icefairy2/Arduino-CNC/doc_pictures/33380556_2360984187275571_8499630215952072704_n.jpg

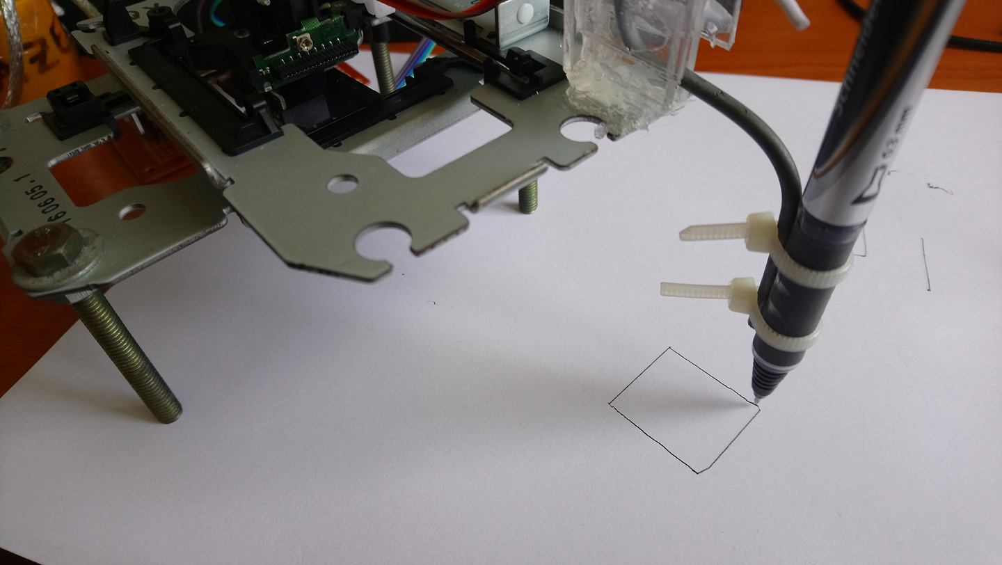
doc_pictures/33380556_2360984187275571_8499630215952072704_n.jpg
