icefairy2/Arduino-CNC/doc_pictures/30739119_2306908542683136_1899229100862603264_n.jpg

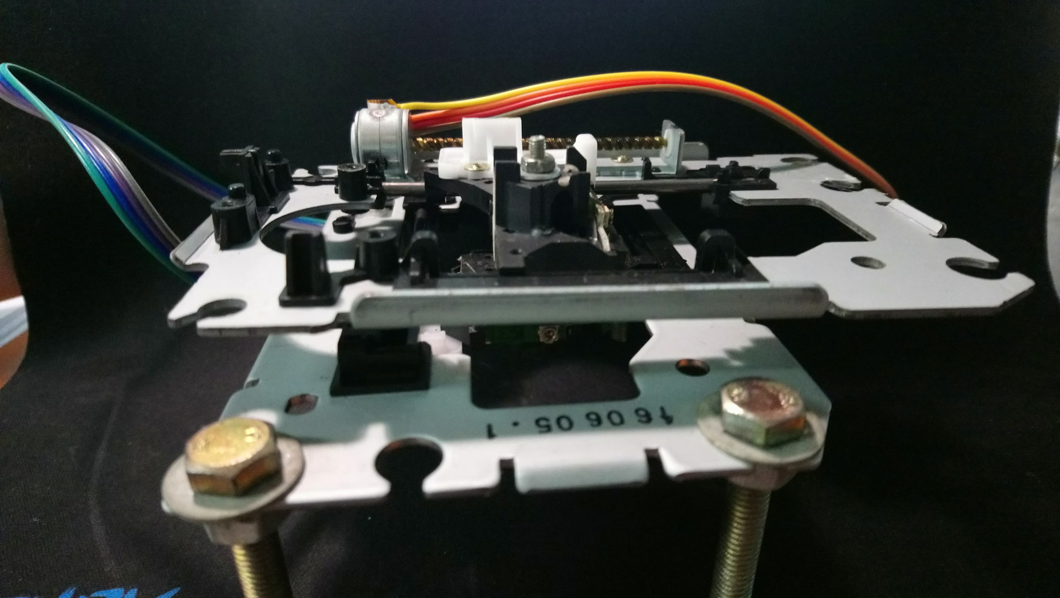
doc_pictures/30739119_2306908542683136_1899229100862603264_n.jpg
