icefairy2/Arduino-CNC/doc_pictures/30706027_2306908366016487_955904147784204288_n.jpg

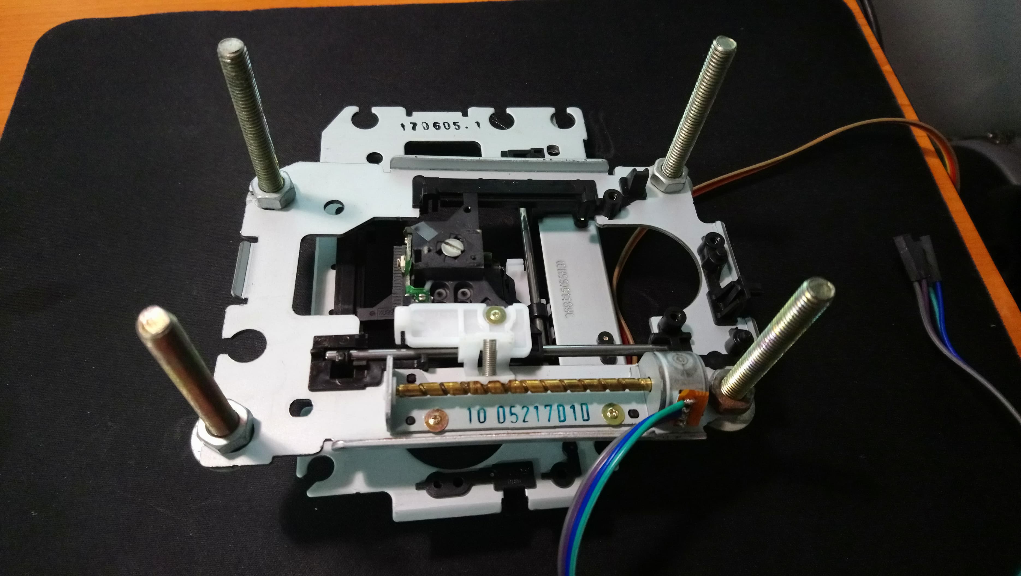
doc_pictures/30706027_2306908366016487_955904147784204288_n.jpg
