icefairy2/Arduino-CNC/doc_pictures/30709478_2306804792693511_1586290099979550720_n.jpg

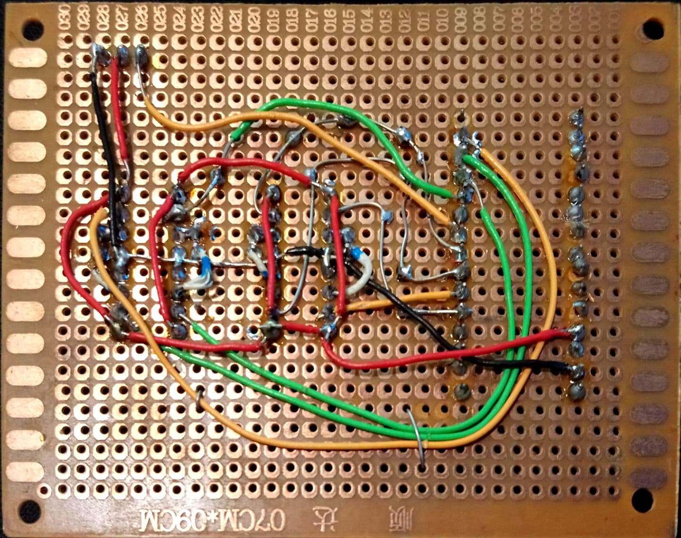
doc_pictures/30709478_2306804792693511_1586290099979550720_n.jpg
