icefairy2/Arduino-CNC/doc_pictures/30711003_2306845702689420_721806899481149440_n.jpg

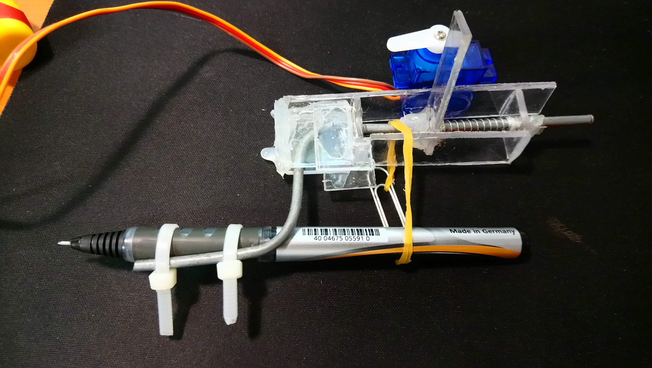
doc_pictures/30711003_2306845702689420_721806899481149440_n.jpg
