icefairy2/Arduino-CNC/doc_pictures/30714753_2306908376016486_1086549236088045568_n.jpg

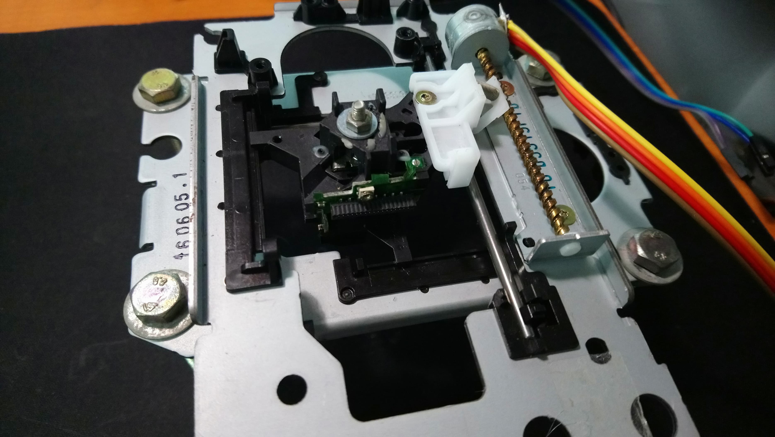
doc_pictures/30714753_2306908376016486_1086549236088045568_n.jpg
