icefairy2/Arduino-CNC/doc_pictures/30716480_2306908196016504_6861736277184610304_n.jpg

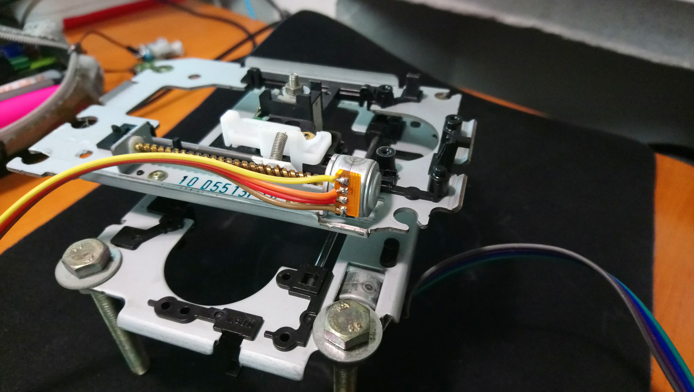
doc_pictures/30716480_2306908196016504_6861736277184610304_n.jpg
