icefairy2/Arduino-CNC/doc_pictures/30727038_2306908006016523_6195921844139196416_n.jpg

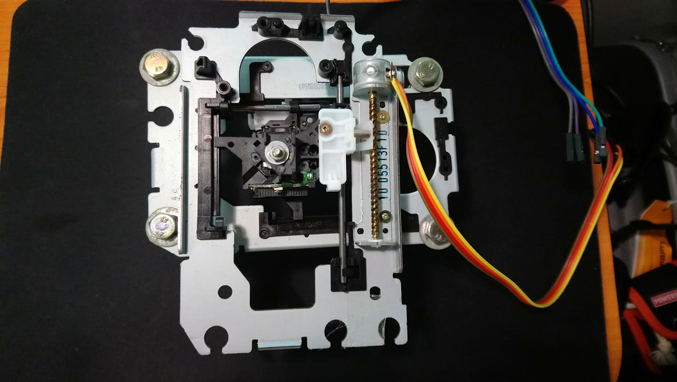
doc_pictures/30727038_2306908006016523_6195921844139196416_n.jpg
