icefairy2/Arduino-CNC/doc_pictures/30738338_2306907972683193_2224676223332646912_n.jpg

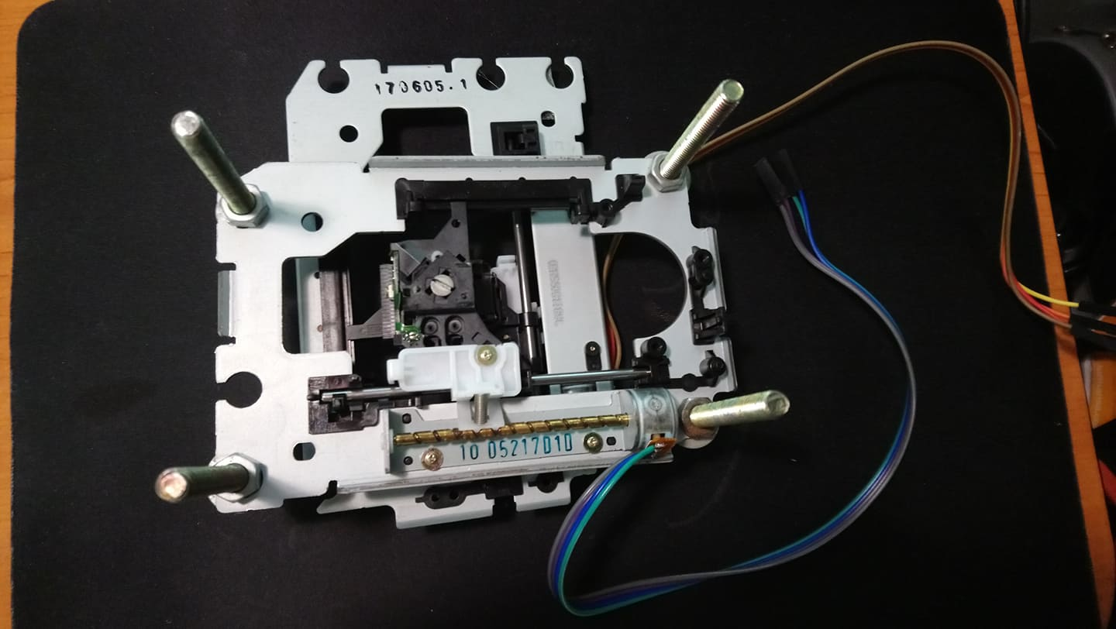
doc_pictures/30738338_2306907972683193_2224676223332646912_n.jpg
