icefairy2/Arduino-CNC/doc_pictures/33426469_2360984143942242_2757224916469153792_n.jpg

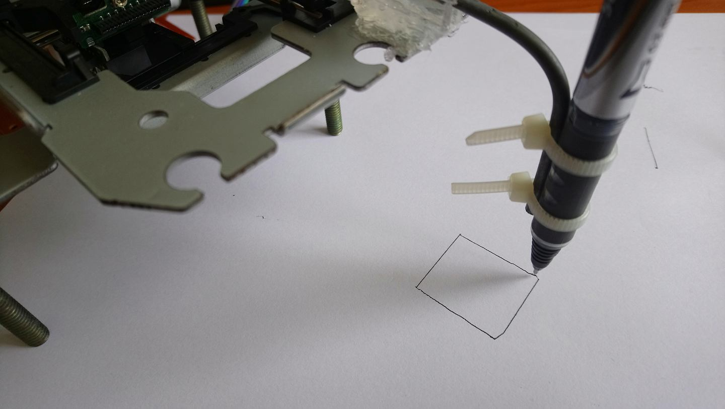
doc_pictures/33426469_2360984143942242_2757224916469153792_n.jpg
