icefairy2/Arduino-CNC/doc_pictures/Schematic_CNC-machine_Sheet-1_20180411154136.png

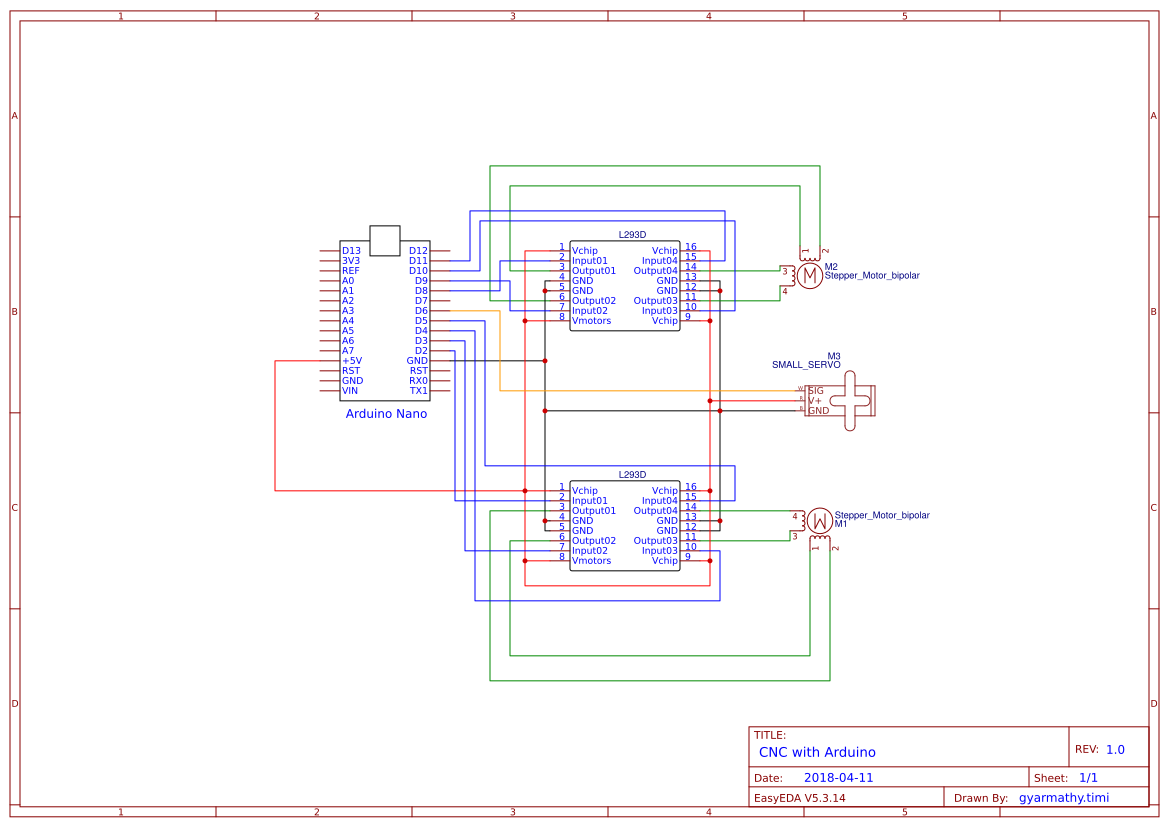
doc_pictures/Schematic_CNC-machine_Sheet-1_20180411154136.png
