icefairy2/Arduino-CNC/doc_pictures/usecaseSCS.png

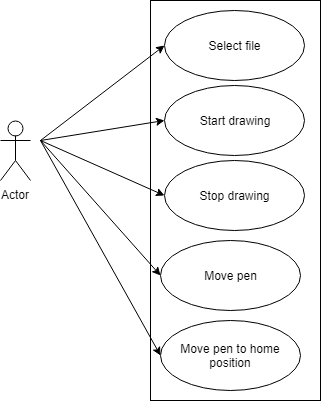
doc_pictures/usecaseSCS.png
