icefairy2/Arduino-CNC/prop_pictures/Smurfette_2.jpg

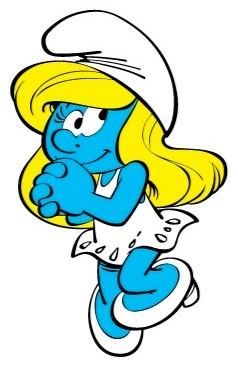
prop_pictures/Smurfette_2.jpg
