icefairy2/Arduino-CNC/prop_pictures/Smurfette_4.jpg

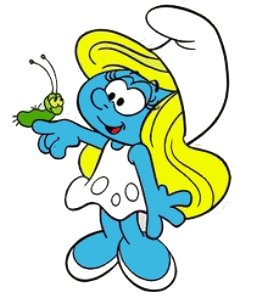
prop_pictures/Smurfette_4.jpg
