icefairy2/Arduino-CNC/prop_pictures/Squirtle.jpg

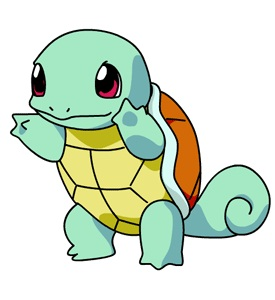
prop_pictures/Squirtle.jpg
