icefairy2/Arduino-CNC/doc_pictures/How_to_Make_a_CNC_machine_at_home-a4778d03dafd4d7db3cfac38e67b1e7c.png

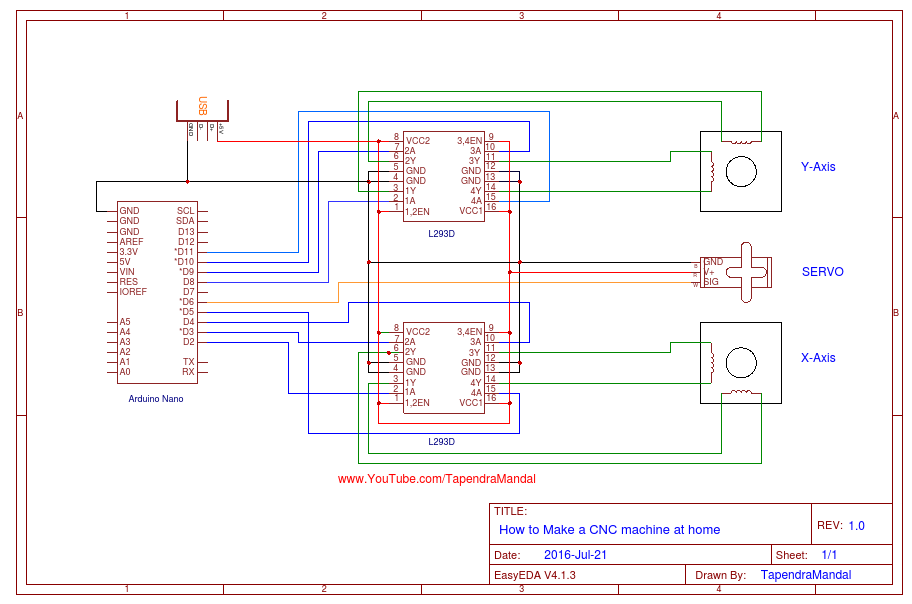
doc_pictures/How_to_Make_a_CNC_machine_at_home-a4778d03dafd4d7db3cfac38e67b1e7c.png
